dionys28/Micro-Air-Vehicle/Micro_Air_Vehicle.kicad_pcb

## KiCad design Micro_Air_Vehicle.kicad_pcb (2026-11-14)

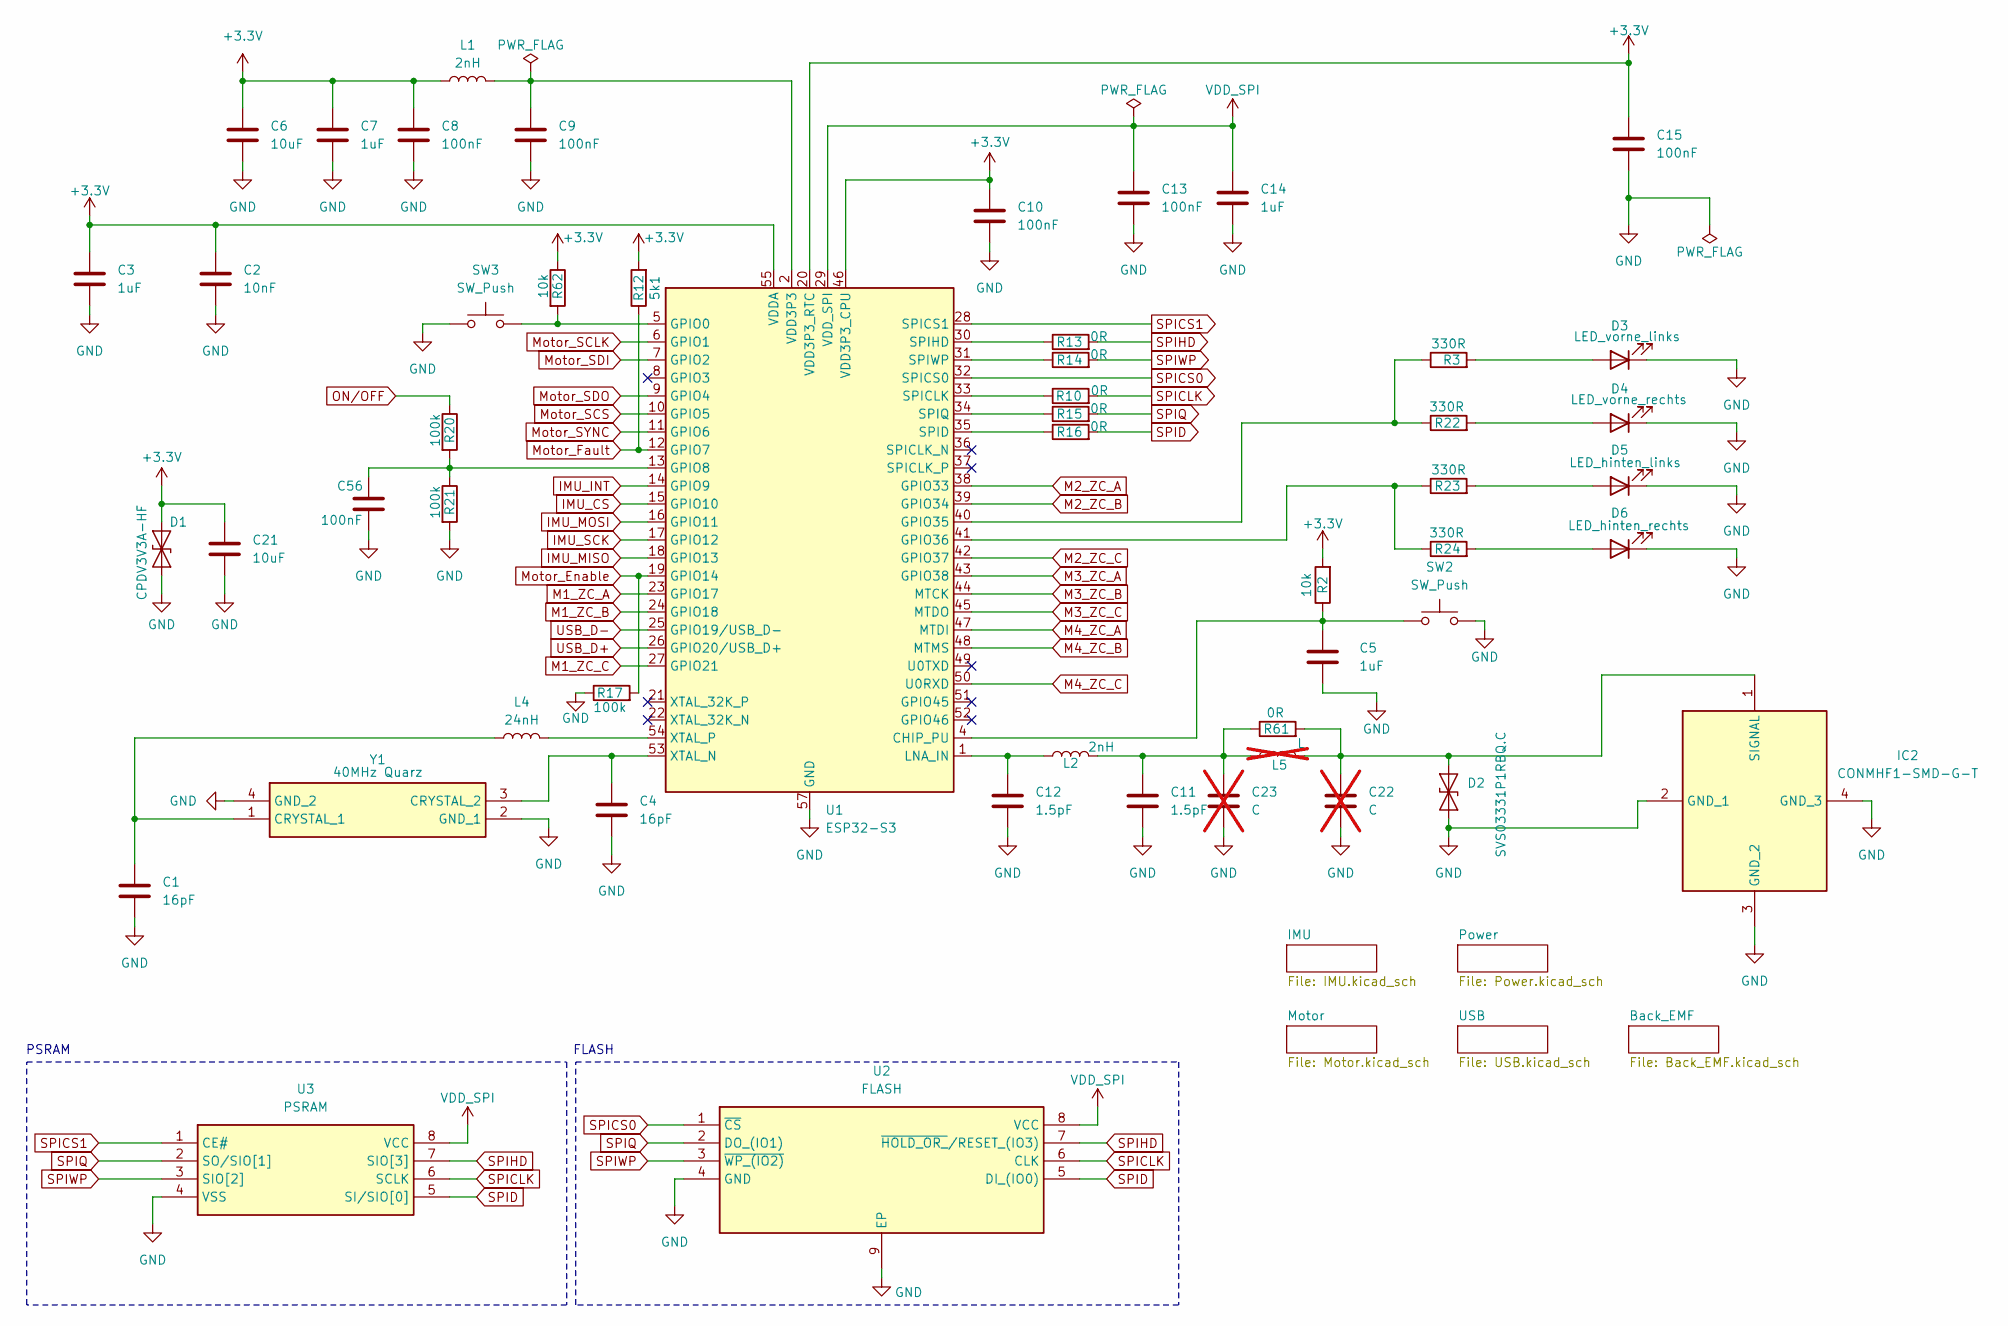
[picture p1: schematic Micro_Air_Vehicle.kicad_sch]

Parts:
C1, C4: 16pF; C_0603_1608Metric
C2: 10nF; C_0603_1608Metric
C3, C5, C7, C14: 1uF; C_0805_2012Metric
C6, C21: 10uF; C_0805_2012Metric
C8, C9, C10, C13, C15, C56: 100nF; C_0603_1608Metric
C11, C12: 1.5pF; C_0201_0603Metric
C22, C23: C; C_0201_0603Metric; not fitted
D1: CPDV3V3A-HF; Diode_D1
D2: SVS03331P1RBQ.C
D3: LED_vorne_links; LED_1206_3216Metric
D4: LED_vorne_rechts; LED_1206_3216Metric
D5: LED_hinten_links; LED_1206_3216Metric
D6: LED_hinten_rechts; LED_1206_3216Metric
IC2: CONMHF1-SMD-G-T; Antennen_Stecker; Mouser Part Number 712-CONMHF1-SMD-G-T
L1, L2: 2nH; L_0201_0603Metric
L4: 24nH; L_0201_0603Metric
L5: L; L_0201_0603Metric; not fitted
R2, R62: 10k; R_0603_1608Metric
R3, R22, R23, R24: 330R; R_0603_1608Metric
R10, R13, R14, R15, R16, R61: 0R; R_0603_1608Metric
R12: 5k1; R_0603_1608Metric
R17, R20, R21: 100k; R_0603_1608Metric
SW2, SW3: SW_Push; SW_Push_1P1T_NO_CK_KMR2
U1: ESP32-S3; QFN-56-1EP_7x7mm_P0.4mm_EP4x4mm
U2: FLASH; Mouser Part Number 454-W25Q64JVZPIM
U3: PSRAM; Mouser Part Number 485-4677
Y1: 40MHz Quarz; 40MHz_Quarz; Mouser Part Number 710-830108208709

Connections:
+3.3V: C2.1, C3.1, C6.1, C7.1, C8.1, C10.1, C15.1, C21.1, D1.2 (A2), L1.1, R2.2, R12.2, R62.1, U1.20 (VDD3P3_RTC), U1.46 (VDD3P3_CPU), U1.55 (VDDA), U1.56 (VDDA); also elsewhere on the board
GND: C1.2, C2.2, C3.2, C4.2, C5.2, C6.2, C7.2, C8.2, C9.2, C10.2, C11.2, C12.2, C13.2, C14.2, C15.2, C21.2, C22.2, C23.2, C56.2, D1.1 (A1), D2.1 (A1), D3.1 (K), D4.1 (K), D5.1 (K), D6.1 (K), IC2.2 (GND_1), IC2.3 (GND_2), IC2.4 (GND_3), R17.1, R21.2, SW2.2, SW3.1, U1.57 (GND), U2.4 (GND), U2.9 (EP), U3.4 (VSS), Y1.2 (GND_1), Y1.4 (GND_2); also elsewhere on the board
IMU_CS: U1.15 (GPIO10); also elsewhere on the board
IMU_INT: U1.14 (GPIO9); also elsewhere on the board
IMU_MISO: U1.18 (GPIO13); also elsewhere on the board
IMU_MOSI: U1.16 (GPIO11); also elsewhere on the board
IMU_SCK: U1.17 (GPIO12); also elsewhere on the board
M1_ZC_A: U1.23 (GPIO17); also elsewhere on the board
M1_ZC_B: U1.24 (GPIO18); also elsewhere on the board
M1_ZC_C: U1.27 (GPIO21); also elsewhere on the board
M2_ZC_A: U1.38 (GPIO33); also elsewhere on the board
M2_ZC_B: U1.39 (GPIO34); also elsewhere on the board
M2_ZC_C: U1.42 (GPIO37); also elsewhere on the board
M3_ZC_A: U1.43 (GPIO38); also elsewhere on the board
M3_ZC_B: U1.44 (MTCK); also elsewhere on the board
M3_ZC_C: U1.45 (MTDO); also elsewhere on the board
M4_ZC_A: U1.47 (MTDI); also elsewhere on the board
M4_ZC_B: U1.48 (MTMS); also elsewhere on the board
M4_ZC_C: U1.50 (U0RXD); also elsewhere on the board
Motor_Enable: R17.2, U1.19 (GPIO14); also elsewhere on the board
Motor_Fault: R12.1, U1.12 (GPIO7); also elsewhere on the board
Motor_SCLK: U1.6 (GPIO1); also elsewhere on the board
Motor_SCS: U1.10 (GPIO5); also elsewhere on the board
Motor_SDI: U1.7 (GPIO2); also elsewhere on the board
Motor_SDO: U1.9 (GPIO4); also elsewhere on the board
Motor_SYNC: U1.11 (GPIO6); also elsewhere on the board
unnamed: C9.1, L1.2, U1.2 (VDD3P3), U1.3 (VDD3P3)
unnamed: C11.1, C23.1, L2.2, L5.1, R61.1
unnamed: C22.1, D2.2 (A2), IC2.1 (SIGNAL), L5.2, R61.2
unnamed: D3.2 (A), R3.2
unnamed: D4.2 (A), R22.2
unnamed: D5.2 (A), R23.2
unnamed: D6.2 (A), R24.2
unnamed: C5.1, R2.1, SW2.1, U1.4 (CHIP_PU)
unnamed: R62.2, SW3.2, U1.5 (GPIO0)
unnamed: C56.1, R20.2, R21.1, U1.13 (GPIO8)
unnamed: R3.1, R22.1, U1.40 (GPIO35)
unnamed: R23.1, R24.1, U1.41 (GPIO36)
unnamed: C12.1, L2.1, U1.1 (LNA_IN)
unnamed: R10.1, U1.33 (SPICLK)
unnamed: R16.1, U1.35 (SPID)
unnamed: R13.1, U1.30 (SPIHD)
unnamed: R15.1, U1.34 (SPIQ)
unnamed: R14.1, U1.31 (SPIWP)
unnamed: C4.1, U1.53 (XTAL_N), Y1.3 (CRYSTAL_2)
unnamed: L4.2, U1.54 (XTAL_P)
unnamed: C1.1, L4.1, Y1.1 (CRYSTAL_1)
ON/OFF: R20.1; also elsewhere on the board
SPICLK: R10.2, U2.6 (CLK), U3.6 (SCLK)
SPICS0: U1.32 (SPICS0), U2.1 (~CS)
SPICS1: U1.28 (SPICS1), U3.1 (CE#)
SPID: R16.2, U2.5 (DI_(IO0)), U3.5 (SI/SIO[0])
SPIHD: R13.2, U2.7 (~HOLD_OR_/RESET_(IO3)), U3.7 (SIO[3])
SPIQ: R15.2, U2.2 (DO_(IO1)), U3.2 (SO/SIO[1])
SPIWP: R14.2, U2.3 (~WP_(IO2)), U3.3 (SIO[2])
USB_D+: U1.26 (GPIO20/USB_D+); also elsewhere on the board
USB_D-: U1.25 (GPIO19/USB_D-); also elsewhere on the board
VDD_SPI: C13.1, C14.1, U1.29 (VDD_SPI), U2.8 (VCC), U3.8 (VCC)

Notes on the sheet:
PSRAM
FLASH

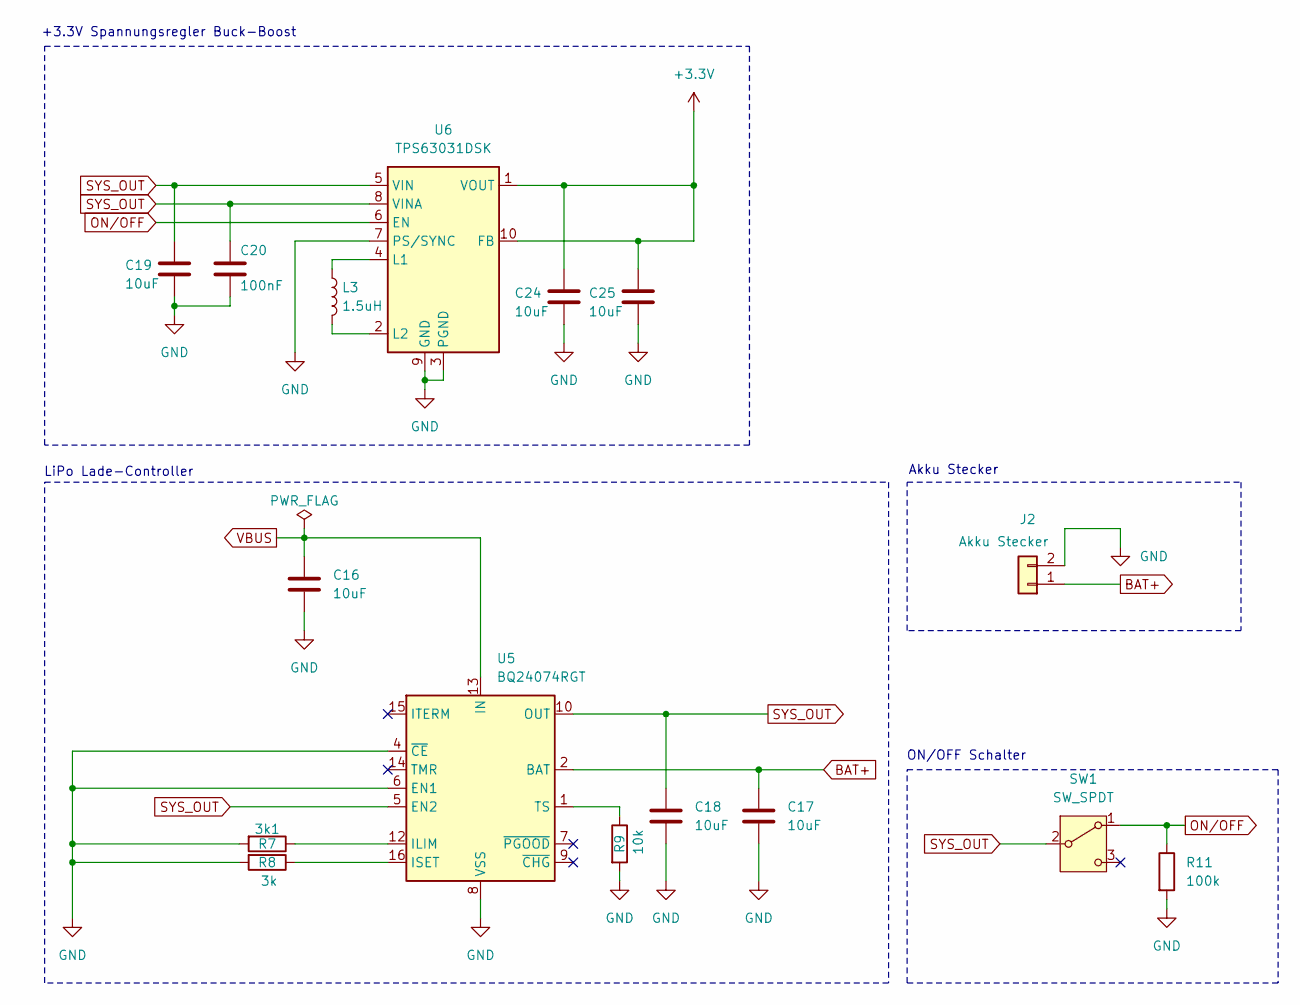
[picture p2: schematic Power.kicad_sch]

Parts:
C16, C17, C18, C19, C24, C25: 10uF; C_0805_2012Metric
C20: 100nF; C_0603_1608Metric
J2: Akku Stecker; SolderWire-1sqmm_1x02_P5.4mm_D1.4mm_OD2.7mm
L3: 1.5uH; Spule1.5uH
R7: 3k1; R_0603_1608Metric
R8: 3k; R_0603_1608Metric
R9: 10k; R_0603_1608Metric
R11: 100k; R_0603_1608Metric
SW1: SW_SPDT; SW_SPDT_CK_JS102011SAQN
U5: BQ24074RGT; VQFN-16-1EP_3x3mm_P0.5mm_EP1.68x1.68mm_ThermalVias
U6: TPS63031DSK; WSON-10-1EP_2.5x2.5mm_P0.5mm_EP1.2x2mm_ThermalVias

Connections:
+3.3V: C24.1, C25.1, U6.1 (VOUT), U6.10 (FB); also elsewhere on the board
BAT+: C17.1, J2.1, U5.2 (BAT), U5.3 (BAT); also elsewhere on the board
GND: C16.2, C17.2, C18.2, C19.2, C20.2, C24.2, C25.2, J2.2, R7.2, R8.2, R9.2, R11.2, U5.4 (~CE), U5.6 (EN1), U5.8 (VSS), U5.17 (VSS), U6.3 (PGND), U6.7 (PS/SYNC), U6.9 (GND), U6.11 (PGND); also elsewhere on the board
unnamed: R7.1, U5.12 (ILIM)
unnamed: R8.1, U5.16 (ISET)
unnamed: R9.1, U5.1 (TS)
unnamed: L3.1, U6.4 (L1)
unnamed: L3.2, U6.2 (L2)
ON/OFF: R11.1, SW1.1 (A), U6.6 (EN); also elsewhere on the board
SYS_OUT: C18.1, C19.1, C20.1, SW1.2 (B), U5.5 (EN2), U5.10 (OUT), U5.11 (OUT), U6.5 (VIN), U6.8 (VINA); also elsewhere on the board
VBUS: C16.1, U5.13 (IN); also elsewhere on the board

Notes on the sheet:
ON/OFF Schalter
Akku Stecker
+3.3V Spannungsregler Buck-Boost
LiPo Lade-Controller

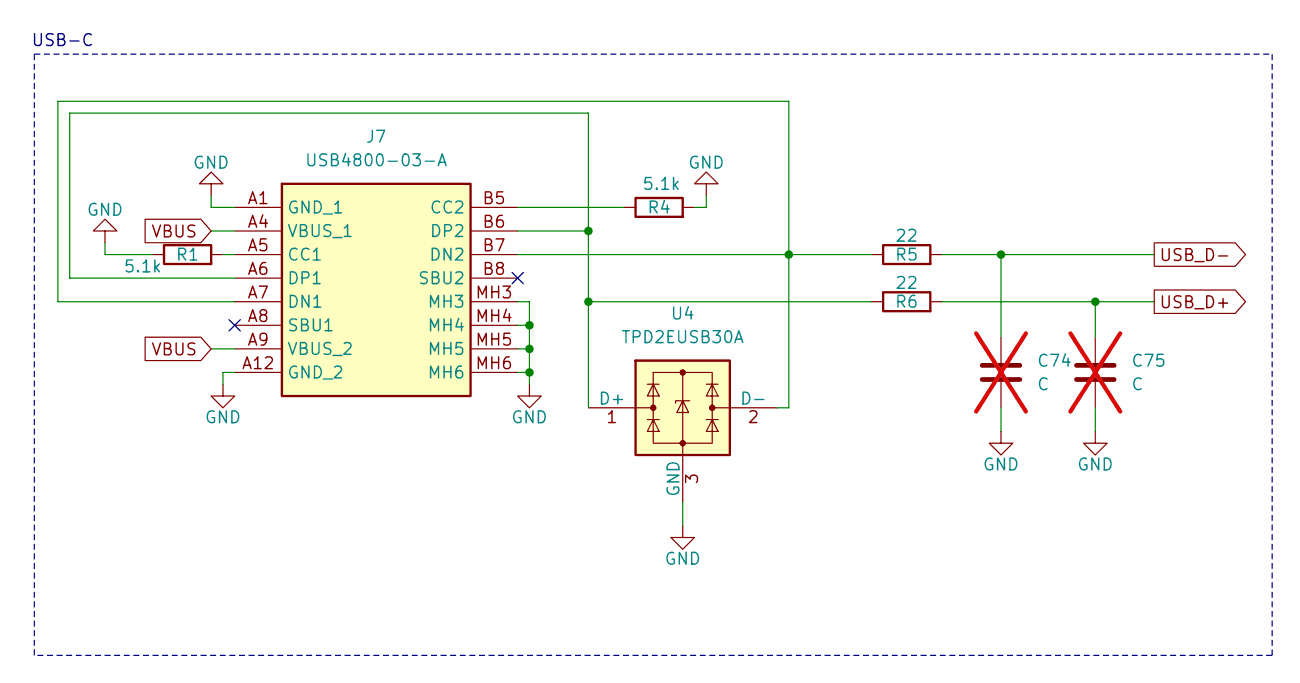
[picture p3: schematic USB.kicad_sch]

Parts:
C74, C75: C; C_0603_1608Metric; not fitted
J7: USB4800-03-A; USB480003A; Mouser Part Number 640-USB4800-03-A
R1, R4: 5.1k; R_0603_1608Metric
R5, R6: 22; R_0603_1608Metric
U4: TPD2EUSB30A; TPD2EUSB30ADRTR

Connections:
GND: C74.2, C75.2, J7.A1 (GND_1), J7.A12 (GND_2), J7.MH3, J7.MH4, J7.MH5, J7.MH6, R1.1, R4.2, U4.3 (GND); also elsewhere on the board
unnamed: J7.A5 (CC1), R1.2
unnamed: J7.B5 (CC2), R4.1
unnamed: J7.A7 (DN1), J7.B7 (DN2), R5.1, U4.2 (D-)
unnamed: J7.A6 (DP1), J7.B6 (DP2), R6.1, U4.1 (D+)
USB_D+: C75.1, R6.2; also elsewhere on the board
USB_D-: C74.1, R5.2; also elsewhere on the board
VBUS: J7.A4 (VBUS_1), J7.A9 (VBUS_2); also elsewhere on the board

Notes on the sheet:
USB-C

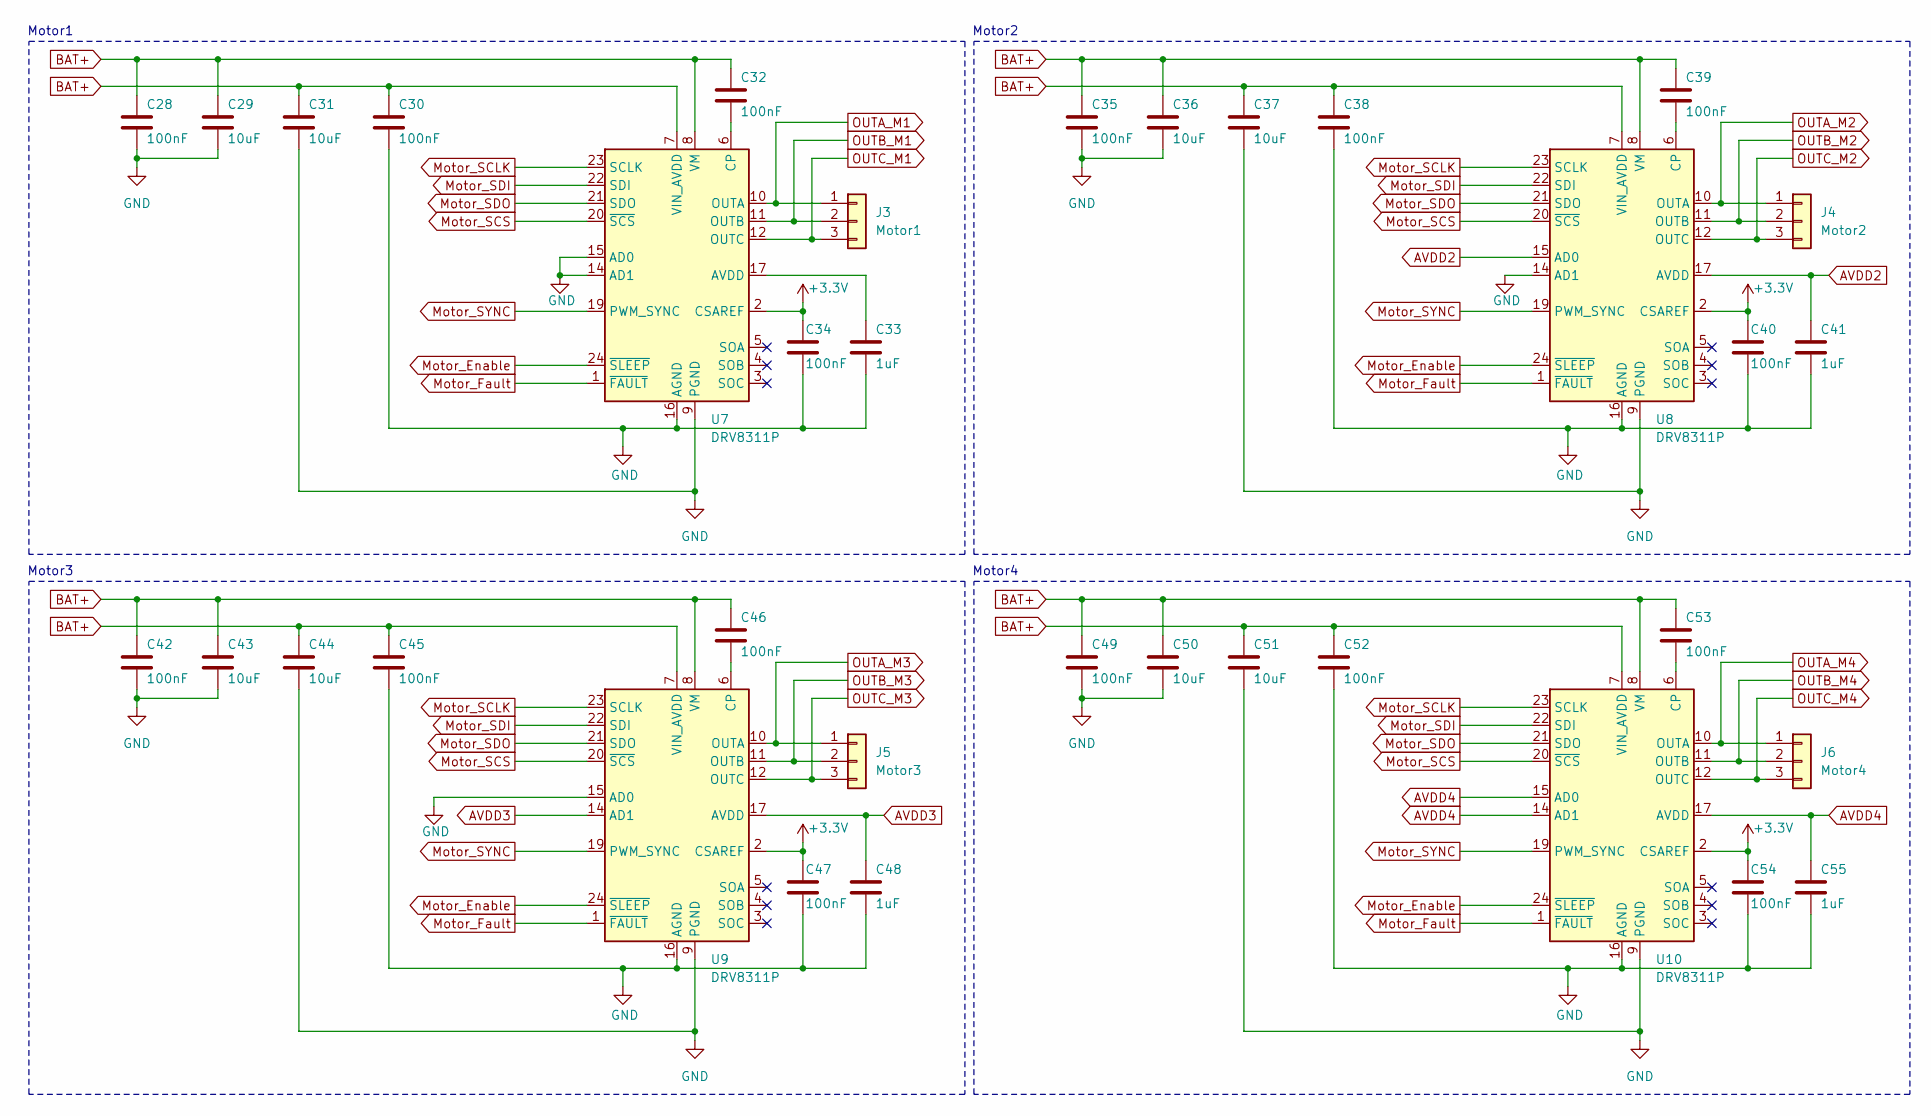
[picture p4: schematic Motor.kicad_sch]

Parts:
C28, C30, C32, C34, C35, C38, C39, C40, C42, C45, C46, C47, C49, C52, C53, C54: 100nF; C_0603_1608Metric
C29, C31, C36, C37, C43, C44, C50, C51: 10uF; C_0805_2012Metric
C33, C41, C48, C55: 1uF; C_0805_2012Metric
J3: Motor1; SolderWire-0.1sqmm_1x03_P3.6mm_D0.4mm_OD1mm
J4: Motor2; SolderWire-0.1sqmm_1x03_P3.6mm_D0.4mm_OD1mm
J5: Motor3; SolderWire-0.1sqmm_1x03_P3.6mm_D0.4mm_OD1mm
J6: Motor4; SolderWire-0.1sqmm_1x03_P3.6mm_D0.4mm_OD1mm
U7, U8, U9, U10: DRV8311P; Texas_RRW0024A_WQFN-24-1EP_3x3mm_P0.4mm_EP1.9x1.9mm

Connections:
+3.3V: C34.1, C40.1, C47.1, C54.1, U7.2 (CSAREF), U8.2 (CSAREF), U9.2 (CSAREF), U10.2 (CSAREF); also elsewhere on the board
AVDD2: C41.1, U8.15 (AD0), U8.17 (AVDD)
AVDD3: C48.1, U9.14 (AD1), U9.17 (AVDD)
AVDD4: C55.1, U10.14 (AD1), U10.15 (AD0), U10.17 (AVDD)
BAT+: C28.1, C29.1, C30.1, C31.1, C32.1, C35.1, C36.1, C37.1, C38.1, C39.1, C42.1, C43.1, C44.1, C45.1, C46.1, C49.1, C50.1, C51.1, C52.1, C53.1, U7.7 (VIN_AVDD), U7.8 (VM), U8.7 (VIN_AVDD), U8.8 (VM), U9.7 (VIN_AVDD), U9.8 (VM), U10.7 (VIN_AVDD), U10.8 (VM); also elsewhere on the board
GND: C28.2, C29.2, C30.2, C31.2, C33.2, C34.2, C35.2, C36.2, C37.2, C38.2, C40.2, C41.2, C42.2, C43.2, C44.2, C45.2, C47.2, C48.2, C49.2, C50.2, C51.2, C52.2, C54.2, C55.2, U7.9 (PGND), U7.14 (AD1), U7.15 (AD0), U7.16 (AGND), U7.25 (PGND), U8.9 (PGND), U8.14 (AD1), U8.16 (AGND), U8.25 (PGND), U9.9 (PGND), U9.15 (AD0), U9.16 (AGND), U9.25 (PGND), U10.9 (PGND), U10.16 (AGND), U10.25 (PGND); also elsewhere on the board
Motor_Enable: U7.24 (~SLEEP), U8.24 (~SLEEP), U9.24 (~SLEEP), U10.24 (~SLEEP); also elsewhere on the board
Motor_Fault: U7.1 (~FAULT), U8.1 (~FAULT), U9.1 (~FAULT), U10.1 (~FAULT); also elsewhere on the board
Motor_SCLK: U7.23 (SCLK), U8.23 (SCLK), U9.23 (SCLK), U10.23 (SCLK); also elsewhere on the board
Motor_SCS: U7.20 (~SCS), U8.20 (~SCS), U9.20 (~SCS), U10.20 (~SCS); also elsewhere on the board
Motor_SDI: U7.22 (SDI), U8.22 (SDI), U9.22 (SDI), U10.22 (SDI); also elsewhere on the board
Motor_SDO: U7.21 (SDO), U8.21 (SDO), U9.21 (SDO), U10.21 (SDO); also elsewhere on the board
Motor_SYNC: U7.19 (PWM_SYNC), U8.19 (PWM_SYNC), U9.19 (PWM_SYNC), U10.19 (PWM_SYNC); also elsewhere on the board
unnamed: C33.1, U7.17 (AVDD)
unnamed: C32.2, U7.6 (CP)
unnamed: C39.2, U8.6 (CP)
unnamed: C46.2, U9.6 (CP)
unnamed: C53.2, U10.6 (CP)
OUTA_M1: J3.1, U7.10 (OUTA); also elsewhere on the board
OUTA_M2: J4.1, U8.10 (OUTA); also elsewhere on the board
OUTA_M3: J5.1, U9.10 (OUTA); also elsewhere on the board
OUTA_M4: J6.1, U10.10 (OUTA); also elsewhere on the board
OUTB_M1: J3.2, U7.11 (OUTB); also elsewhere on the board
OUTB_M2: J4.2, U8.11 (OUTB); also elsewhere on the board
OUTB_M3: J5.2, U9.11 (OUTB); also elsewhere on the board
OUTB_M4: J6.2, U10.11 (OUTB); also elsewhere on the board
OUTC_M1: J3.3, U7.12 (OUTC); also elsewhere on the board
OUTC_M2: J4.3, U8.12 (OUTC); also elsewhere on the board
OUTC_M3: J5.3, U9.12 (OUTC); also elsewhere on the board
OUTC_M4: J6.3, U10.12 (OUTC); also elsewhere on the board

Notes on the sheet:
Motor3
Motor2
Motor4
Motor1

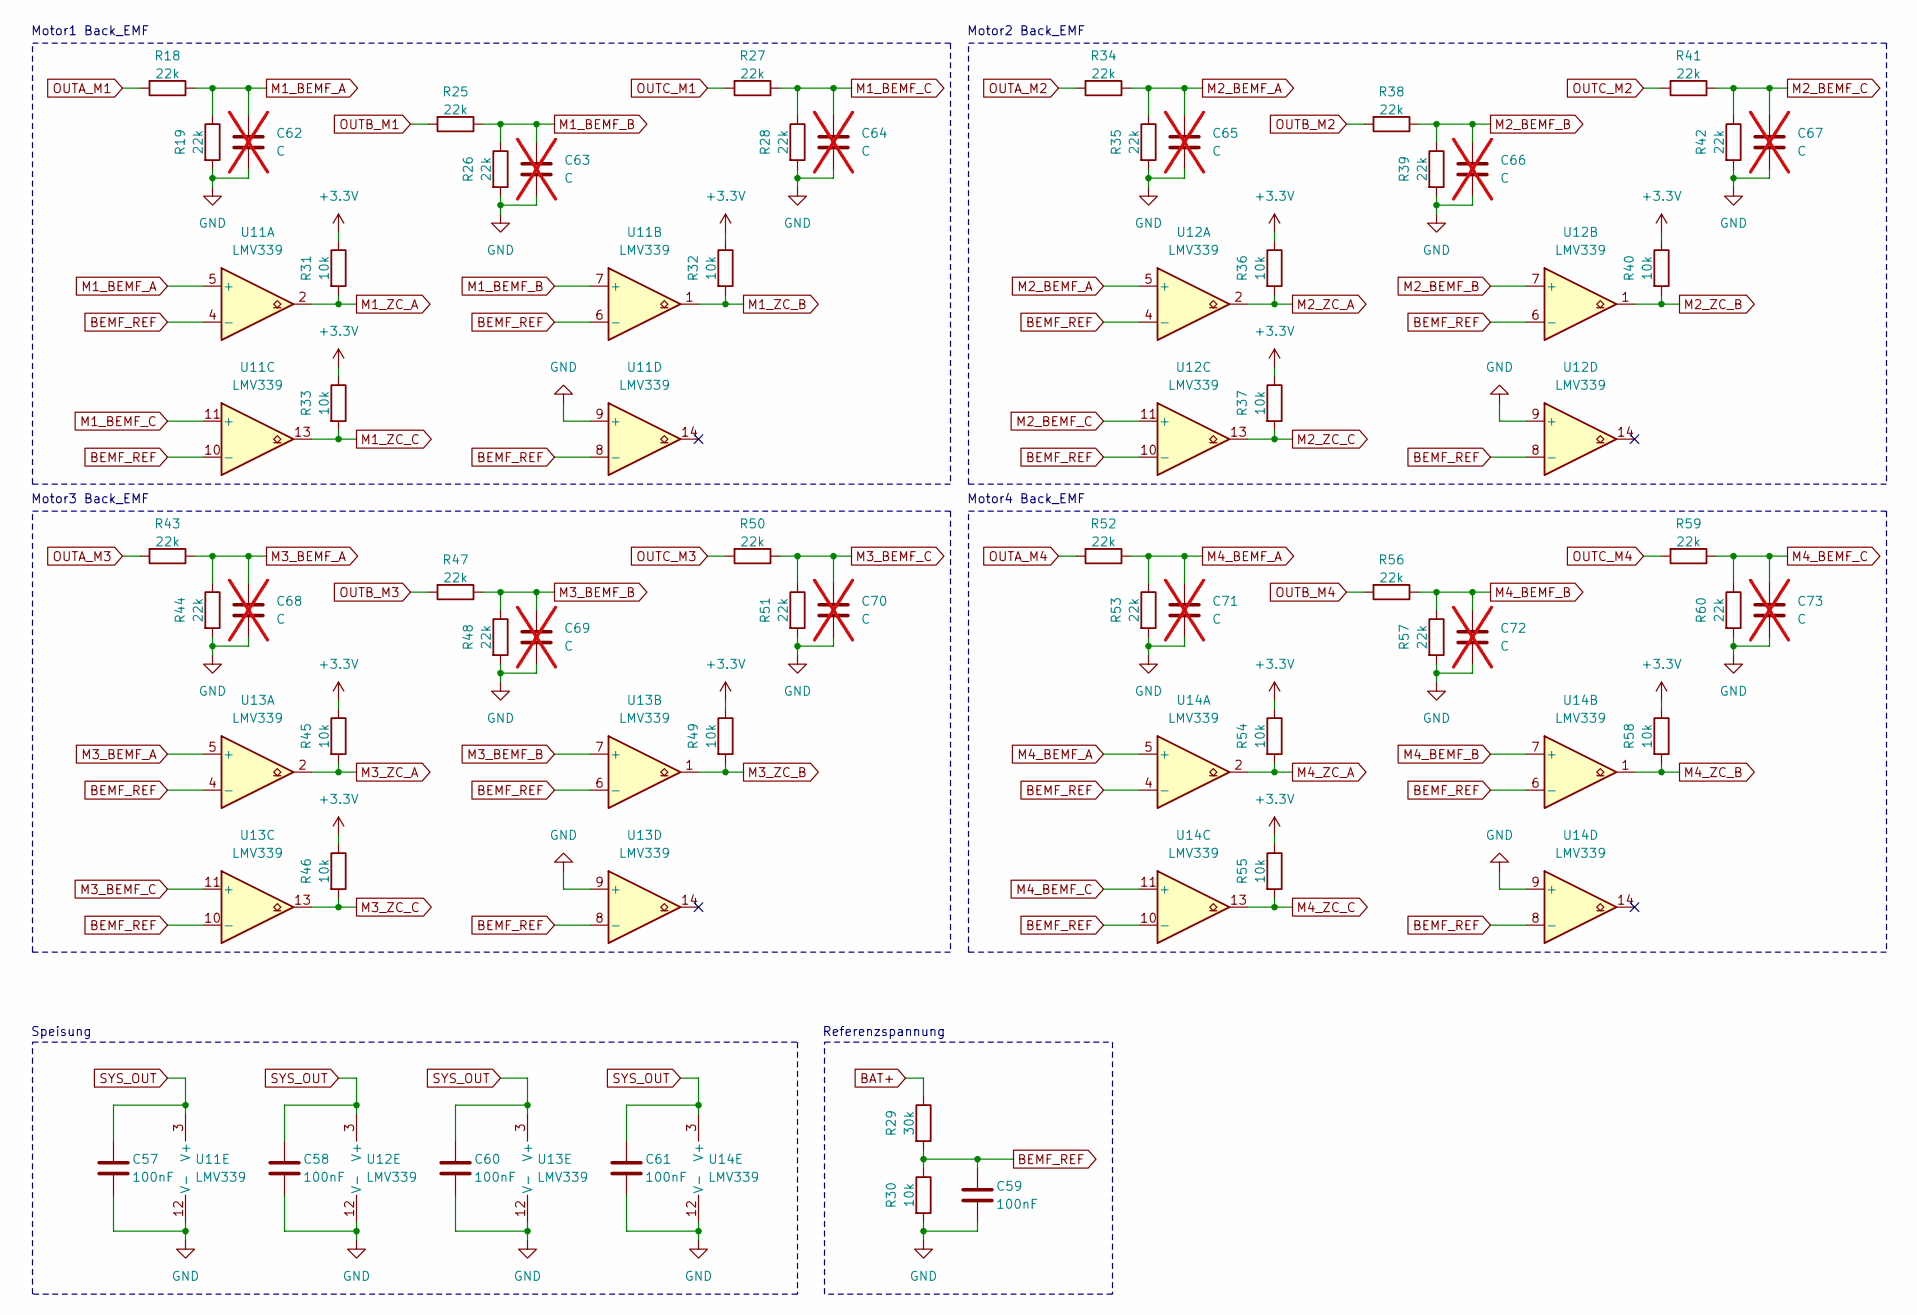
[picture p5: schematic Back_EMF.kicad_sch]

Parts:
C57, C58, C59, C60, C61: 100nF; C_0603_1608Metric
C62, C63, C64, C65, C66, C67, C68, C69, C70, C71, C72, C73: C; C_0603_1608Metric; not fitted
R18, R19, R25, R26, R27, R28, R34, R35, R38, R39, R41, R42, R43, R44, R47, R48, R50, R51, R52, R53, R56, R57, R59, R60: 22k; R_0603_1608Metric
R29: 30k; R_0603_1608Metric
R30, R31, R32, R33, R36, R37, R40, R45, R46, R49, R54, R55, R58: 10k; R_0603_1608Metric
U11, U12, U13, U14: LMV339; LMV339IPWR

Connections:
+3.3V: R31.1, R32.1, R33.1, R36.1, R37.1, R40.1, R45.1, R46.1, R49.1, R54.1, R55.1, R58.1; also elsewhere on the board
BAT+: R29.1; also elsewhere on the board
BEMF_REF: C59.1, R29.2, R30.1, U11.4 (-), U11.6 (-), U11.8 (-), U11.10 (-), U12.4 (-), U12.6 (-), U12.8 (-), U12.10 (-), U13.4 (-), U13.6 (-), U13.8 (-), U13.10 (-), U14.4 (-), U14.6 (-), U14.8 (-), U14.10 (-)
GND: C57.2, C58.2, C59.2, C60.2, C61.2, C62.2, C63.2, C64.2, C65.2, C66.2, C67.2, C68.2, C69.2, C70.2, C71.2, C72.2, C73.2, R19.2, R26.2, R28.2, R30.2, R35.2, R39.2, R42.2, R44.2, R48.2, R51.2, R53.2, R57.2, R60.2, U11.9 (+), U11.12 (V-), U12.9 (+), U12.12 (V-), U13.9 (+), U13.12 (V-), U14.9 (+), U14.12 (V-); also elsewhere on the board
M1_BEMF_A: C62.1, R18.1, R19.1, U11.5 (+)
M1_BEMF_B: C63.1, R25.1, R26.1, U11.7 (+)
M1_BEMF_C: C64.1, R27.1, R28.1, U11.11 (+)
M1_ZC_A: R31.2, U11.2; also elsewhere on the board
M1_ZC_B: R32.2, U11.1; also elsewhere on the board
M1_ZC_C: R33.2, U11.13; also elsewhere on the board
M2_BEMF_A: C65.1, R34.1, R35.1, U12.5 (+)
M2_BEMF_B: C66.1, R38.1, R39.1, U12.7 (+)
M2_BEMF_C: C67.1, R41.1, R42.1, U12.11 (+)
M2_ZC_A: R36.2, U12.2; also elsewhere on the board
M2_ZC_B: R40.2, U12.1; also elsewhere on the board
M2_ZC_C: R37.2, U12.13; also elsewhere on the board
M3_BEMF_A: C68.1, R43.1, R44.1, U13.5 (+)
M3_BEMF_B: C69.1, R47.1, R48.1, U13.7 (+)
M3_BEMF_C: C70.1, R50.1, R51.1, U13.11 (+)
M3_ZC_A: R45.2, U13.2; also elsewhere on the board
M3_ZC_B: R49.2, U13.1; also elsewhere on the board
M3_ZC_C: R46.2, U13.13; also elsewhere on the board
M4_BEMF_A: C71.1, R52.1, R53.1, U14.5 (+)
M4_BEMF_B: C72.1, R56.1, R57.1, U14.7 (+)
M4_BEMF_C: C73.1, R59.1, R60.1, U14.11 (+)
M4_ZC_A: R54.2, U14.2; also elsewhere on the board
M4_ZC_B: R58.2, U14.1; also elsewhere on the board
M4_ZC_C: R55.2, U14.13; also elsewhere on the board
OUTA_M1: R18.2; also elsewhere on the board
OUTA_M2: R34.2; also elsewhere on the board
OUTA_M3: R43.2; also elsewhere on the board
OUTA_M4: R52.2; also elsewhere on the board
OUTB_M1: R25.2; also elsewhere on the board
OUTB_M2: R38.2; also elsewhere on the board
OUTB_M3: R47.2; also elsewhere on the board
OUTB_M4: R56.2; also elsewhere on the board
OUTC_M1: R27.2; also elsewhere on the board
OUTC_M2: R41.2; also elsewhere on the board
OUTC_M3: R50.2; also elsewhere on the board
OUTC_M4: R59.2; also elsewhere on the board
SYS_OUT: C57.1, C58.1, C60.1, C61.1, U11.3 (V+), U12.3 (V+), U13.3 (V+), U14.3 (V+); also elsewhere on the board

Notes on the sheet:
Motor3 Back_EMF
Motor2 Back_EMF
Motor4 Back_EMF
Referenzspannung
Motor1 Back_EMF
Speisung

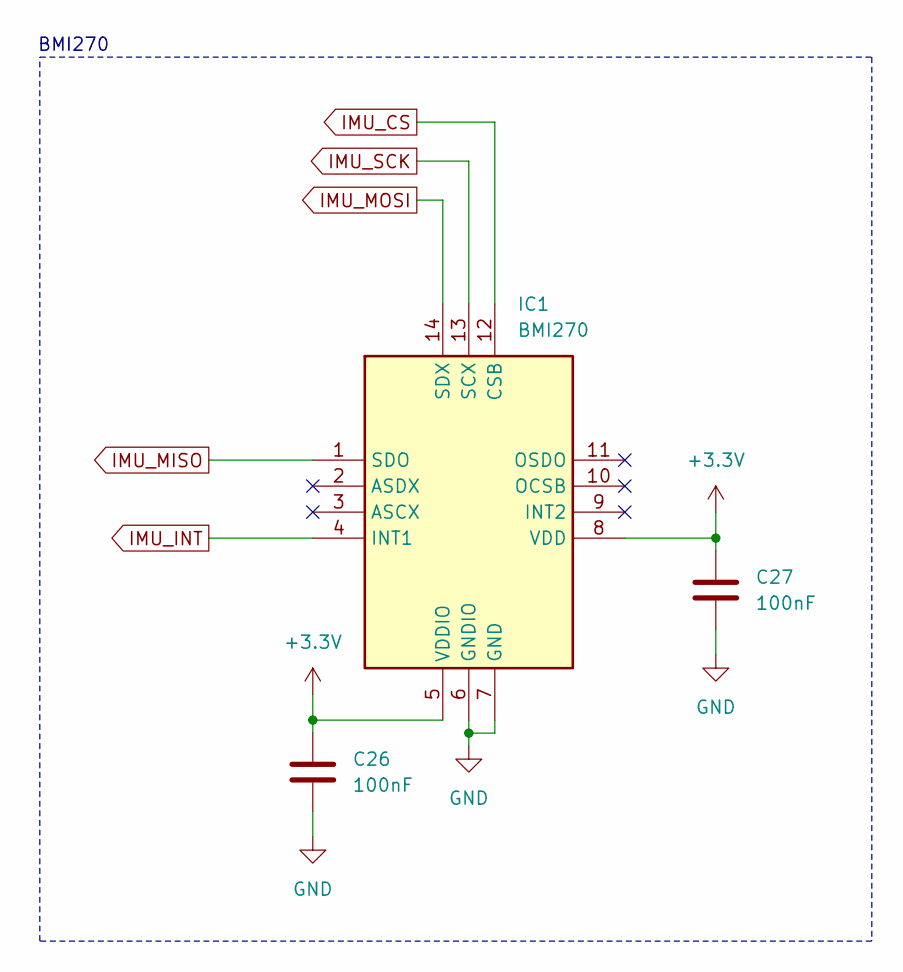
[picture p6: schematic IMU.kicad_sch]

Parts:
C26, C27: 100nF; C_0603_1608Metric
IC1: BMI270; Mouser Part Number 262-BMI270

Connections:
+3.3V: C26.1, C27.1, IC1.5 (VDDIO), IC1.8 (VDD); also elsewhere on the board
GND: C26.2, C27.2, IC1.6 (GNDIO), IC1.7 (GND); also elsewhere on the board
IMU_CS: IC1.12 (CSB); also elsewhere on the board
IMU_INT: IC1.4 (INT1); also elsewhere on the board
IMU_MISO: IC1.1 (SDO); also elsewhere on the board
IMU_MOSI: IC1.14 (SDX); also elsewhere on the board
IMU_SCK: IC1.13 (SCX); also elsewhere on the board

Notes on the sheet:
BMI270

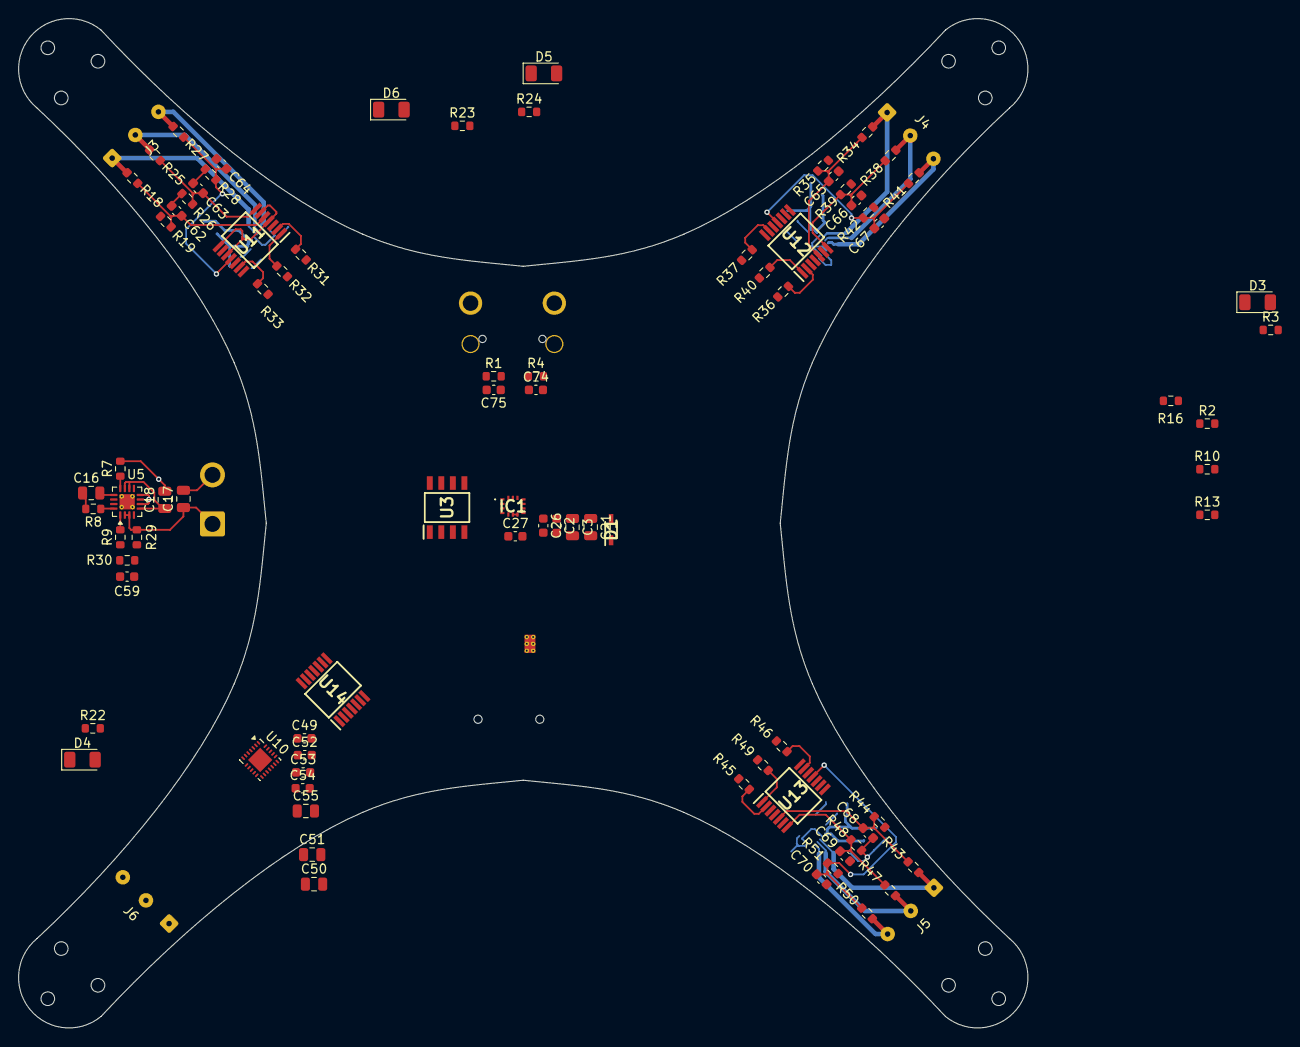
[picture p7: board Micro_Air_Vehicle.kicad_pcb from above]

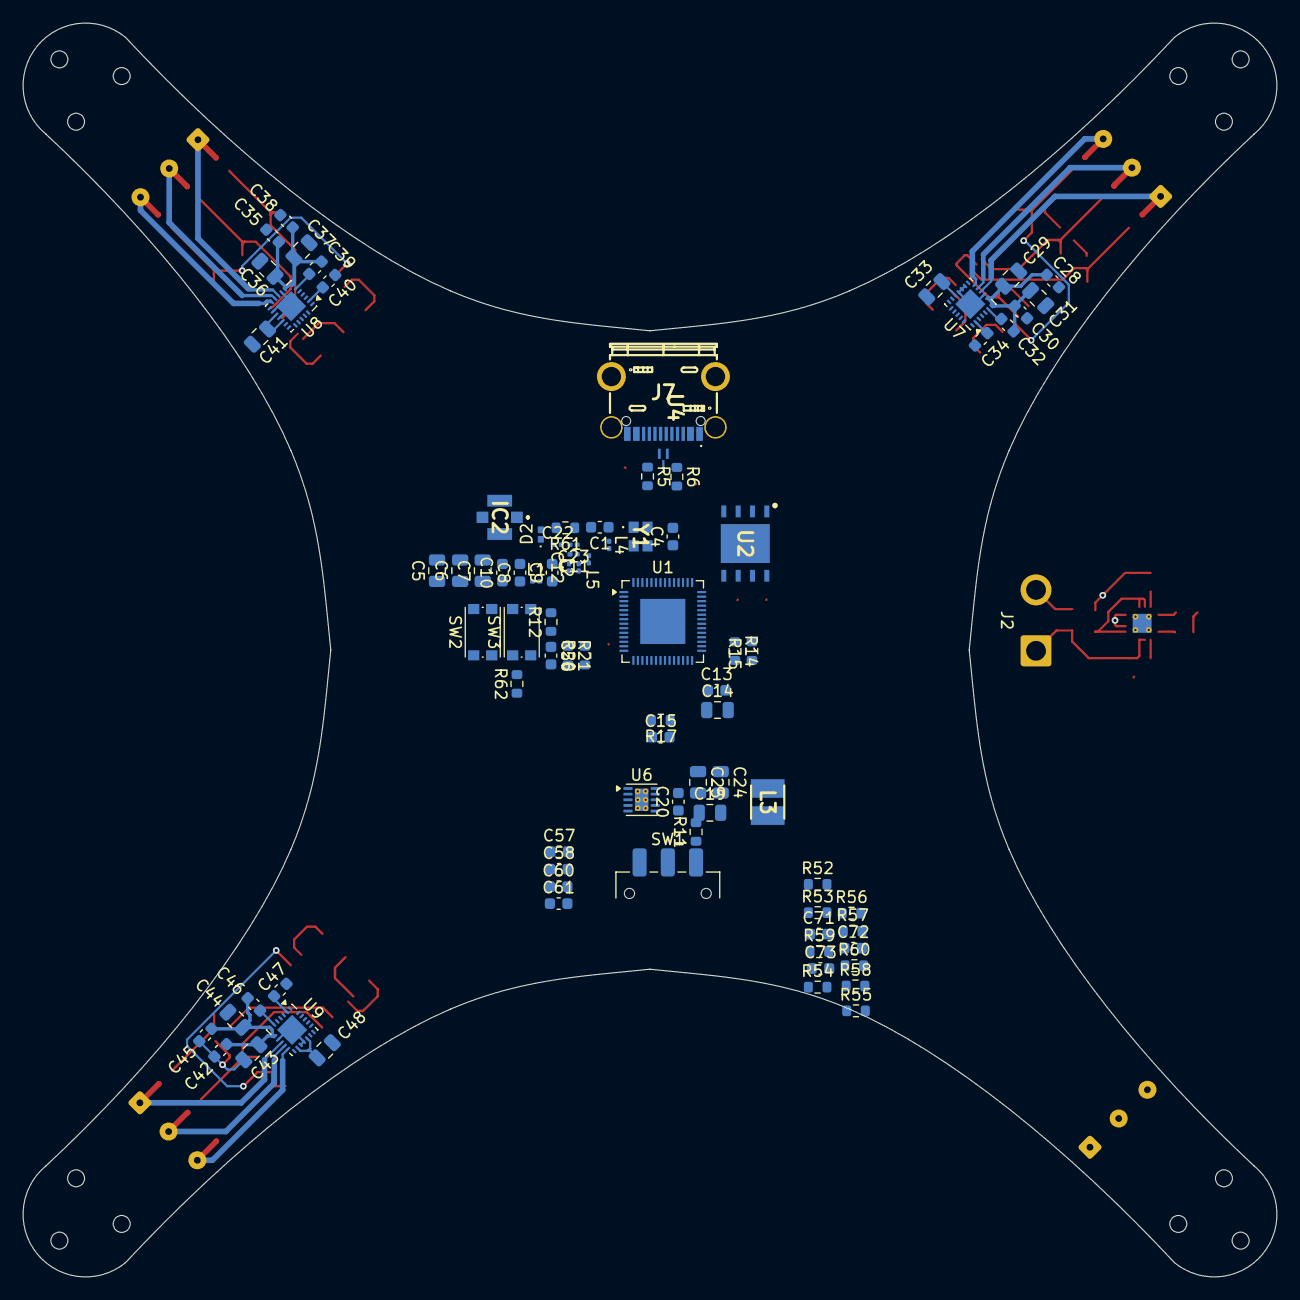
[picture p8: board Micro_Air_Vehicle.kicad_pcb from below]

Board: 4 copper layers, 111.1 x 111.1 mm, 174 parts (88 on the bottom side), 103 nets.
